C-Elegans/cpe_senior_project/desktop_app/README.md

# GTK Desktop App

## GTK Programming Tutorial
https://developer.gnome.org/gtkmm-tutorial/3.24/
