C-Elegans/cpe_senior_project/pcb/senior_project_pcb/senior_project_pcb.kicad_pcb

## KiCad design pcb/senior_project_pcb/senior_project_pcb.kicad_pcb (2021-02-25)

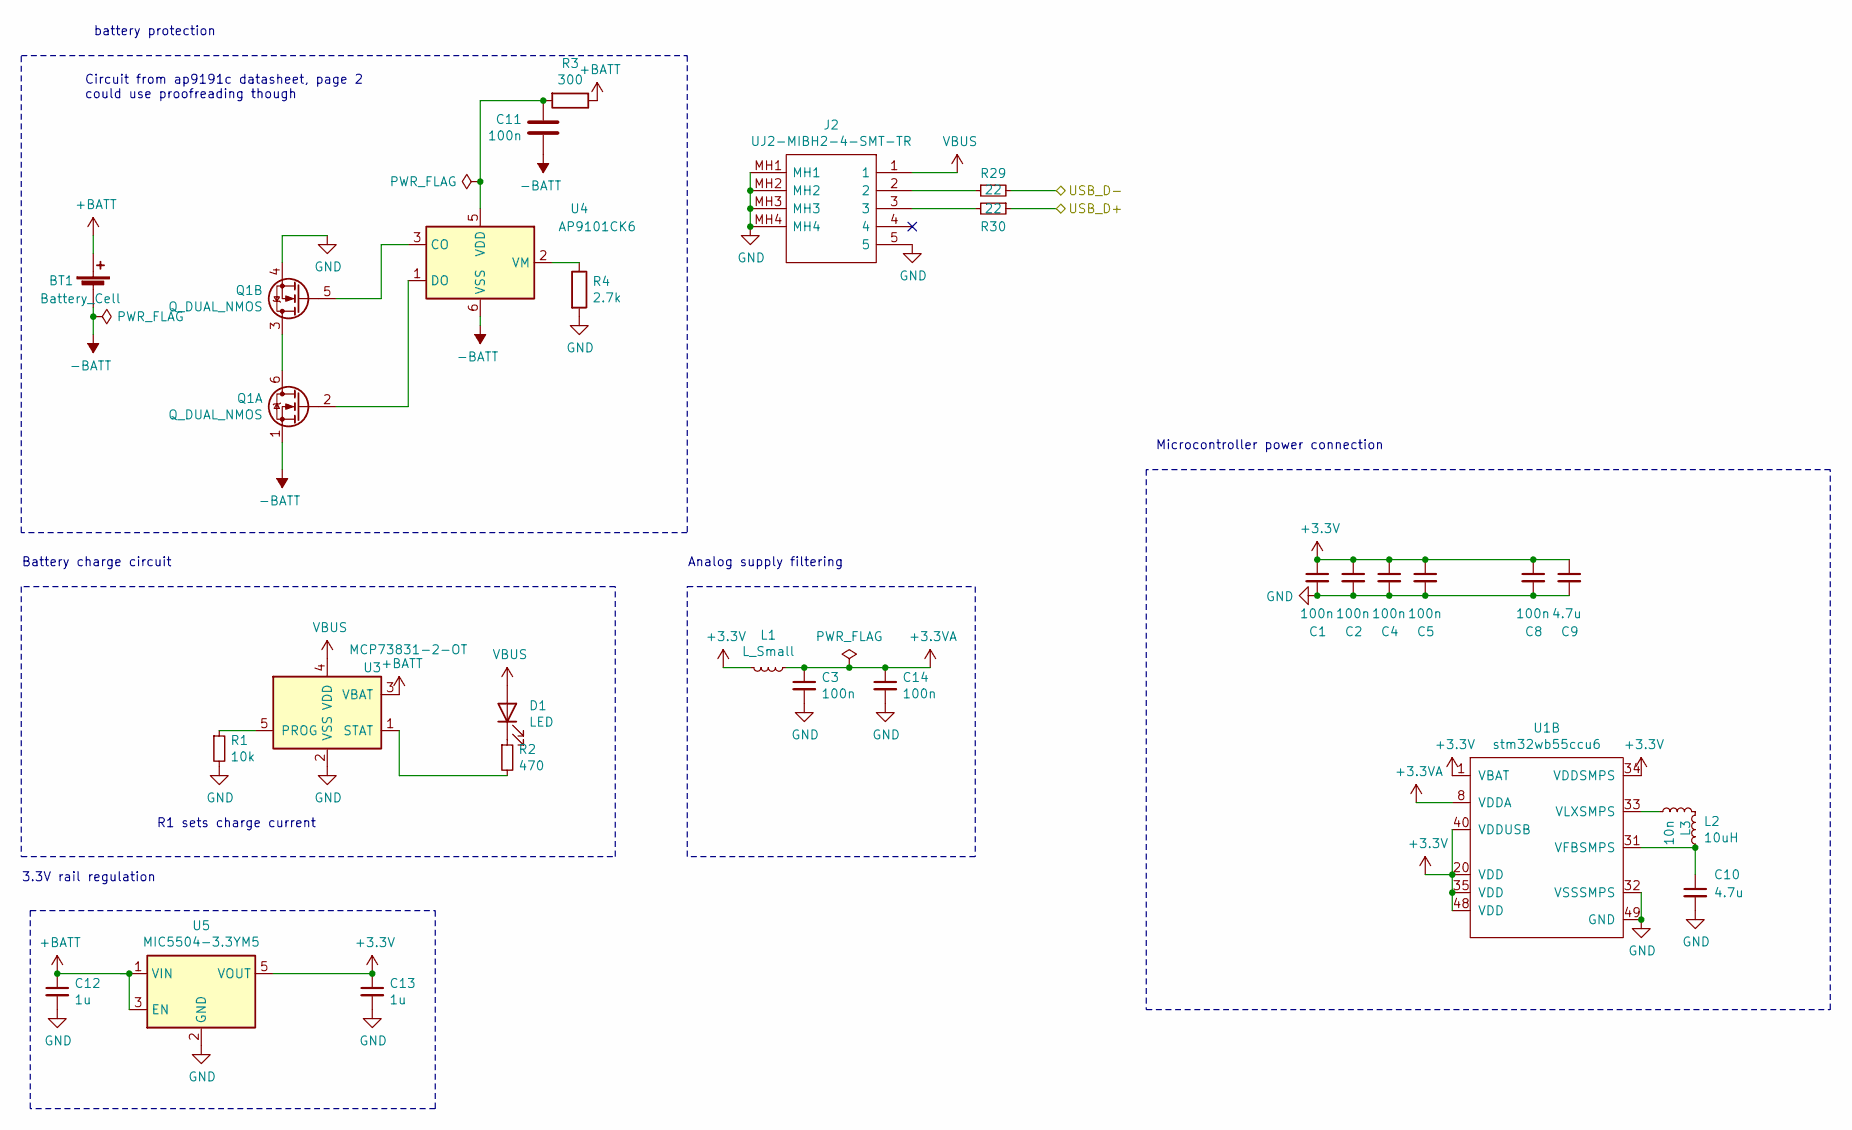
[picture p1: schematic power.sch]

Parts:
BT1: Battery_Cell; PinHeader_1x02_P2.54mm_Vertical
C1, C2, C3, C4, C5, C8, C11, C14: 100n; C_0603_1608Metric; Manufacturer_Part_Number 0603YC104MAT4A; Mouser Part Number 581-0603YC104MAT4A
C9, C10: 4.7u; C_0603_1608Metric; Manufacturer_Part_Number CL10A475KP8NNNC; Mouser Part Number 187-CL10A475KP8NNNC
C12, C13: 1u; C_0603_1608Metric; Manufacturer_Part_Number C0603C105K8PACTU; Mouser Part Number 80-C0603C105K8P
D1: LED; LED_0603_1608Metric; Manufacturer_Part_Number 150060RS75000; Mouser Part Number 710-150060RS75000
J2: UJ2-MIBH2-4-SMT-TR; UJ2MIBH24SMTTR; Manufacturer_Part_Number UJ2-MIBH2-4-SMT-TR; Mouser Part Number 490-UJ2-MIBH2-4-SMT
L1: L_Small; L_0805_2012Metric; Manufacturer_Part_Number LBR2012T100K; Mouser Part Number 963-LBR2012T100K
L2: 10uH; L_0805_2012Metric; Manufacturer_Part_Number LBR2012T100K; Mouser Part Number 963-LBR2012T100K
L3: 10n; L_0402_1005Metric; Manufacturer_Part_Number LQG15WH10NJ02D; Mouser Part Number 81-LQG15WH10NJ02D
Q1: Q_DUAL_NMOS; SOT-363_SC-70-6; Manufacturer_Part_Number BSS138BKS\\,115; Mouser Part Number 771-BSS138BKS115
R1: 10k; R_0603_1608Metric; Manufacturer_Part_Number RC0603FR-0710KL; Mouser Part Number 603-RC0603FR-0710KL
R2: 470; R_0603_1608Metric; Manufacturer_Part_Number RC0603FR-10470RL; Mouser Part Number 603-RC0603FR-10470RL
R3: 300; R_0603_1608Metric; Manufacturer_Part_Number RC0603FR-10300RL; Mouser Part Number 603-RC0603FR-10300RL
R4: 2.7k; R_0603_1608Metric; Manufacturer_Part_Number RC0603FR-072K7L; Mouser Part Number 603-RC0603FR-072K7L
R29, R30: 22; R_0603_1608Metric; Manufacturer_Part_Number RC0603FR-0722RL; Mouser Part Number 603-RC0603FR-0722RL
U1: stm32wb55ccu6; QFN-48-1EP_7x7mm_P0.5mm_EP5.6x5.6mm; Manufacturer_Part_Number STM32WB55CEU6; Mouser Part Number 511-STM32WB55CEU6
U3: MCP73831-2-OT; SOT-23-5; Manufacturer_Part_Number MCP73831T-2DCI/OT; Mouser Part Number 579-MCP73831T-2DCIOT
U4: AP9101CK6; SOT-23-6; Manufacturer_Part_Number AP9101CAK6-AYTRG1; Mouser Part Number 621-AP9101CAK6AYTRG1
U5: MIC5504-3.3YM5; SOT-23-5; Manufacturer_Part_Number MIC5504-3.3YM5-TR; Mouser Part Number 998-MIC5504-3.3YM5TR

Connections:
+3.3VA: C3.1, C14.1, L1.1, U1.8 (VDDA); also elsewhere on the board
+BATT: BT1.1 (+), C12.1, R3.1, U3.3 (VBAT), U5.1 (VIN), U5.3 (EN)
-BATT: BT1.2 (-), C11.1, Q1.1 (S), U4.6 (VSS)
/USB_D+: R29.1; also elsewhere on the board
/USB_D-: R30.2; also elsewhere on the board
GND: C1.2, C2.2, C3.2, C4.2, C5.2, C8.2, C9.2, C10.2, C12.2, C13.2, C14.2, J2.5, J2.MH1, J2.MH2, J2.MH3, J2.MH4, Q1.4 (S), R1.2, R4.2, U1.32 (VSSSMPS), U1.49 (GND), U3.2 (VSS), U5.2 (GND); also elsewhere on the board
unnamed: C10.1, L2.1, U1.31 (VFBSMPS)
unnamed: C11.2, R3.2, U4.5 (VDD)
unnamed: D1.1 (K), R2.1
unnamed: J2.2, R30.1
unnamed: J2.3, R29.2
unnamed: L2.2, L3.2
unnamed: L3.1, U1.33 (VLXSMPS)
unnamed: Q1.2 (G), U4.1 (DO)
unnamed: Q1.3 (D), Q1.6 (D)
unnamed: Q1.5 (G), U4.3 (CO)
unnamed: R1.1, U3.5 (PROG)
unnamed: R2.2, U3.1 (STAT)
unnamed: R4.1, U4.2 (VM)
VBUS: D1.2 (A), J2.1, U3.4 (VDD)

Notes on the sheet:
Circuit from ap9191c datasheet, page 2 could use proofreading though
battery protection
Microcontroller power connection
R1 sets charge current
Battery charge circuit
3.3V rail regulation
Analog supply filtering

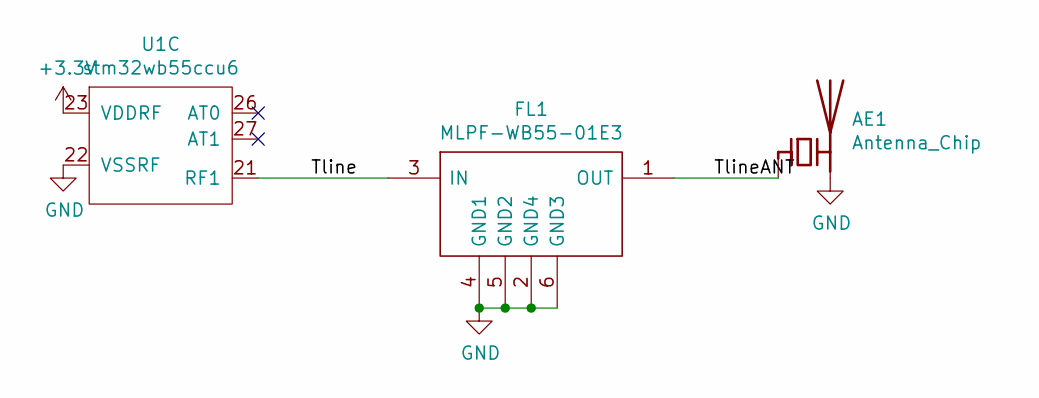
[picture p2: schematic rf.sch]

Parts:
AE1: Antenna_Chip; Texas_SWRA117D_2.4GHz_Left
FL1: MLPF-WB55-01E3; MLPFWB5501E3; Manufacturer_Part_Number MLPF-WB55-01E3; Mouser Part Number 511-MLPF-WB55-01E3
U1: stm32wb55ccu6; QFN-48-1EP_7x7mm_P0.5mm_EP5.6x5.6mm; Manufacturer_Part_Number STM32WB55CEU6; Mouser Part Number 511-STM32WB55CEU6

Connections:
/rf/Tline: FL1.3 (IN), U1.21 (RF1)
/rf/TlineANT: AE1.1 (FEED), FL1.1 (OUT)
GND: AE1.2 (PCB_Trace), FL1.2 (GND4), FL1.4 (GND1), FL1.5 (GND2), FL1.6 (GND3), U1.22 (VSSRF); also elsewhere on the board

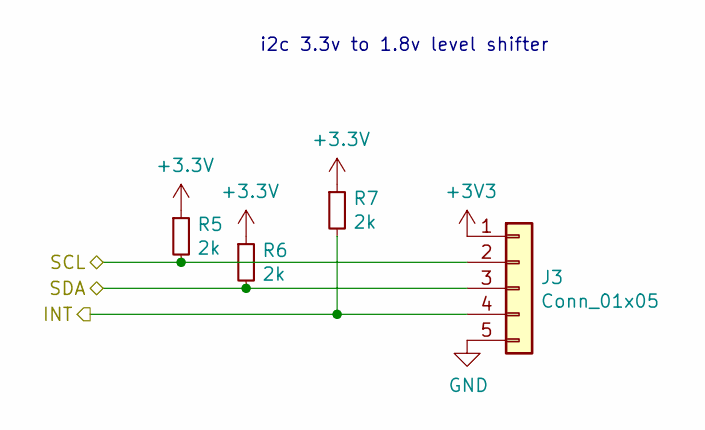
[picture p3: schematic pulse_oxy.sch]

Parts:
J3: Conn_01x05; PinHeader_1x05_P2.54mm_Vertical
R5, R6, R7: 2k; R_0603_1608Metric; Manufacturer_Part_Number RC0603FR-072KL; Mouser Part Number 603-RC0603FR-072KL

Connections:
/INT: J3.4, R7.2; also elsewhere on the board
/SCL: J3.2, R5.2; also elsewhere on the board
/SDA: J3.3, R6.2; also elsewhere on the board
GND: J3.5; also elsewhere on the board

Notes on the sheet:
i2c 3.3v to 1.8v level shifter

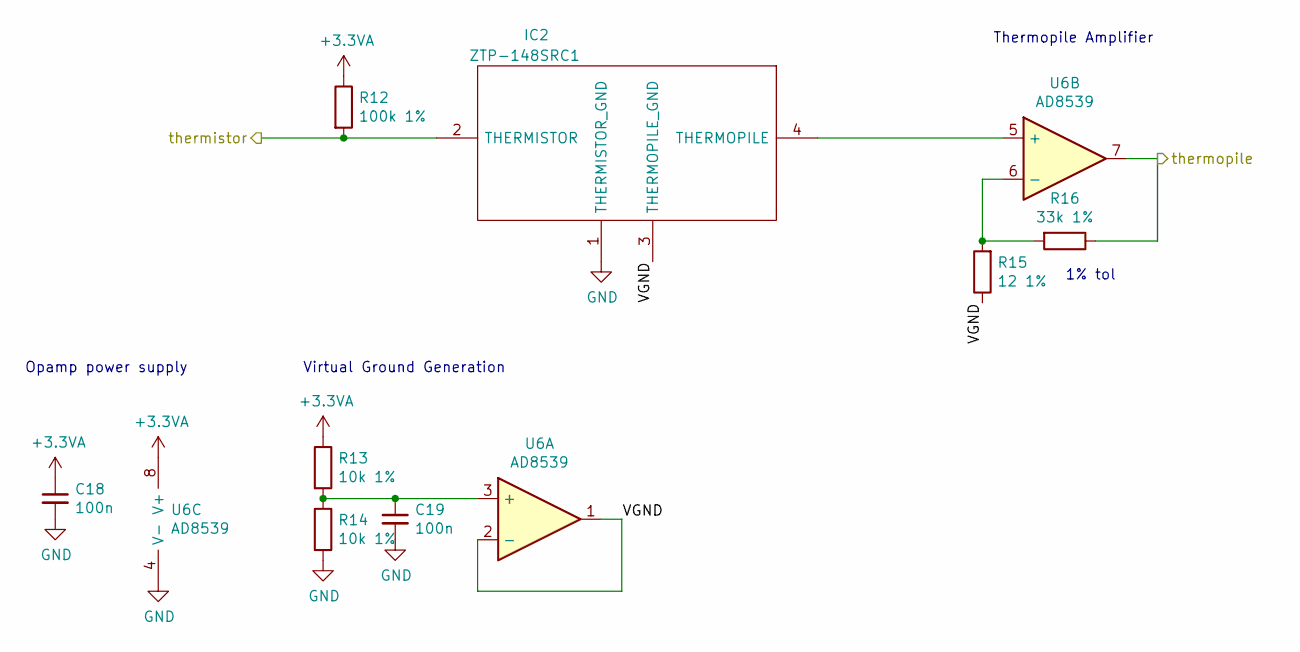
[picture p4: schematic temp_sensor.sch]

Parts:
C18, C19: 100n; C_0603_1608Metric; Manufacturer_Part_Number 0603YC104MAT4A; Mouser Part Number 581-0603YC104MAT4A
IC2: ZTP-148SRC1; ZTP148SRC1; Manufacturer_Part_Number ZTP-148SRC1; Mouser Part Number 527-ZTP-148SRC1
R12: 100k 1%; R_0603_1608Metric; Manufacturer_Part_Number RC0603FR-13100KL; Mouser Part Number 603-RC0603FR-13100KL
R13, R14: 10k 1%; R_0603_1608Metric; Manufacturer_Part_Number RC0603FR-0710KL; Mouser Part Number 603-RC0603FR-0710KL
R15: 12 1%; R_0603_1608Metric; Manufacturer_Part_Number RC0603FR-0712RL; Mouser Part Number 603-RC0603FR-0712RL
R16: 33k 1%; R_0603_1608Metric; Manufacturer_Part_Number RC0603FR-0733KL; Mouser Part Number 603-RC0603FR-0733KL
U6: AD8539; MSOP-8_3x3mm_P0.65mm; Manufacturer_Part_Number AD8539ARMZ; Mouser Part Number 584-AD8539ARMZ

Connections:
+3.3VA: C18.1, R12.1, R13.1, U6.8 (V+); also elsewhere on the board
/Temperature Sensor/VGND: IC2.3 (THERMOPILE_GND), R15.1, U6.1, U6.2 (-)
/thermistor: IC2.2 (THERMISTOR), R12.2; also elsewhere on the board
/thermopile: R16.1, U6.7; also elsewhere on the board
GND: C18.2, C19.2, IC2.1 (THERMISTOR_GND), R14.2, U6.4 (V-); also elsewhere on the board
unnamed: C19.1, R13.2, R14.1, U6.3 (+)
unnamed: IC2.4 (THERMOPILE), U6.5 (+)
unnamed: R15.2, R16.2, U6.6 (-)

Notes on the sheet:
Opamp power supply
Virtual Ground Generation
Thermopile Amplifier
1% tol

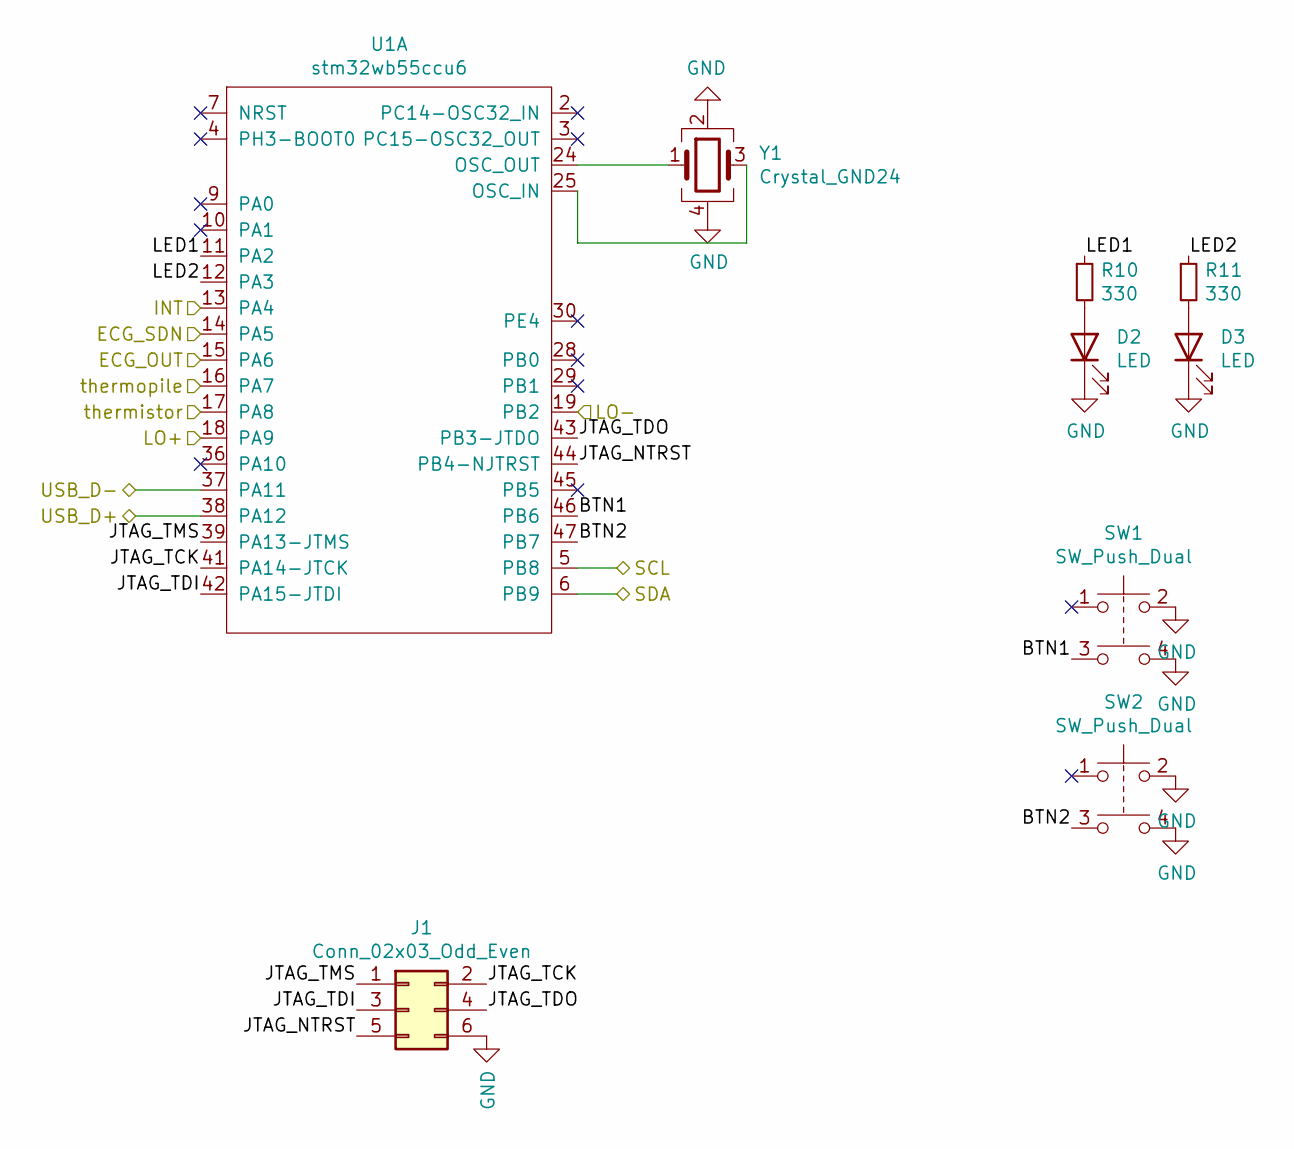
[picture p5: schematic io.sch]

Parts:
D2, D3: LED; LED_0603_1608Metric; Manufacturer_Part_Number 150060RS75000; Mouser Part Number 710-150060RS75000
J1: Conn_02x03_Odd_Even; PinHeader_2x03_P2.54mm_Vertical; Manufacturer_Part_Number 10-89-7061; Mouser Part Number 538-10-89-7061
R10, R11: 330; R_0603_1608Metric; Manufacturer_Part_Number RC0603JR-07330RL; Mouser Part Number 603-RC0603JR-07330RL
SW1, SW2: SW_Push_Dual; LL3301NF065QG; Manufacturer_Part_Number LL3301NF065QG; Mouser Part Number 612-LL3301NF065QG
U1: stm32wb55ccu6; QFN-48-1EP_7x7mm_P0.5mm_EP5.6x5.6mm; Manufacturer_Part_Number STM32WB55CEU6; Mouser Part Number 511-STM32WB55CEU6
Y1: Crystal_GND24; Crystal_SMD_2016-4Pin_2.0x1.6mm; Manufacturer_Part_Number XRCGB32M000F2P02R0; Mouser Part Number 81-XRCGB32M000F2P02R

Connections:
/ECG_OUT: U1.15 (PA6); also elsewhere on the board
/ECG_SDN: U1.14 (PA5); also elsewhere on the board
/INT: U1.13 (PA4); also elsewhere on the board
/LO+: U1.18 (PA9); also elsewhere on the board
/LO-: U1.19 (PB2); also elsewhere on the board
/SCL: U1.5 (PB8); also elsewhere on the board
/SDA: U1.6 (PB9); also elsewhere on the board
/USB_D+: U1.38 (PA12); also elsewhere on the board
/USB_D-: U1.37 (PA11); also elsewhere on the board
/io/BTN1: SW1.3, U1.46 (PB6)
/io/BTN2: SW2.3, U1.47 (PB7)
/io/JTAG_NTRST: J1.5, U1.44 (PB4-NJTRST)
/io/JTAG_TCK: J1.2, U1.41 (PA14-JTCK)
/io/JTAG_TDI: J1.3, U1.42 (PA15-JTDI)
/io/JTAG_TDO: J1.4, U1.43 (PB3-JTDO)
/io/JTAG_TMS: J1.1, U1.39 (PA13-JTMS)
/io/LED1: R10.1, U1.11 (PA2)
/io/LED2: R11.1, U1.12 (PA3)
/thermistor: U1.17 (PA8); also elsewhere on the board
/thermopile: U1.16 (PA7); also elsewhere on the board
GND: D2.1 (K), D3.1 (K), J1.6, SW1.2, SW1.4, SW2.2, SW2.4, Y1.2, Y1.4; also elsewhere on the board
unnamed: D2.2 (A), R10.2
unnamed: D3.2 (A), R11.2
unnamed: U1.24 (OSC_OUT), Y1.1
unnamed: U1.25 (OSC_IN), Y1.3

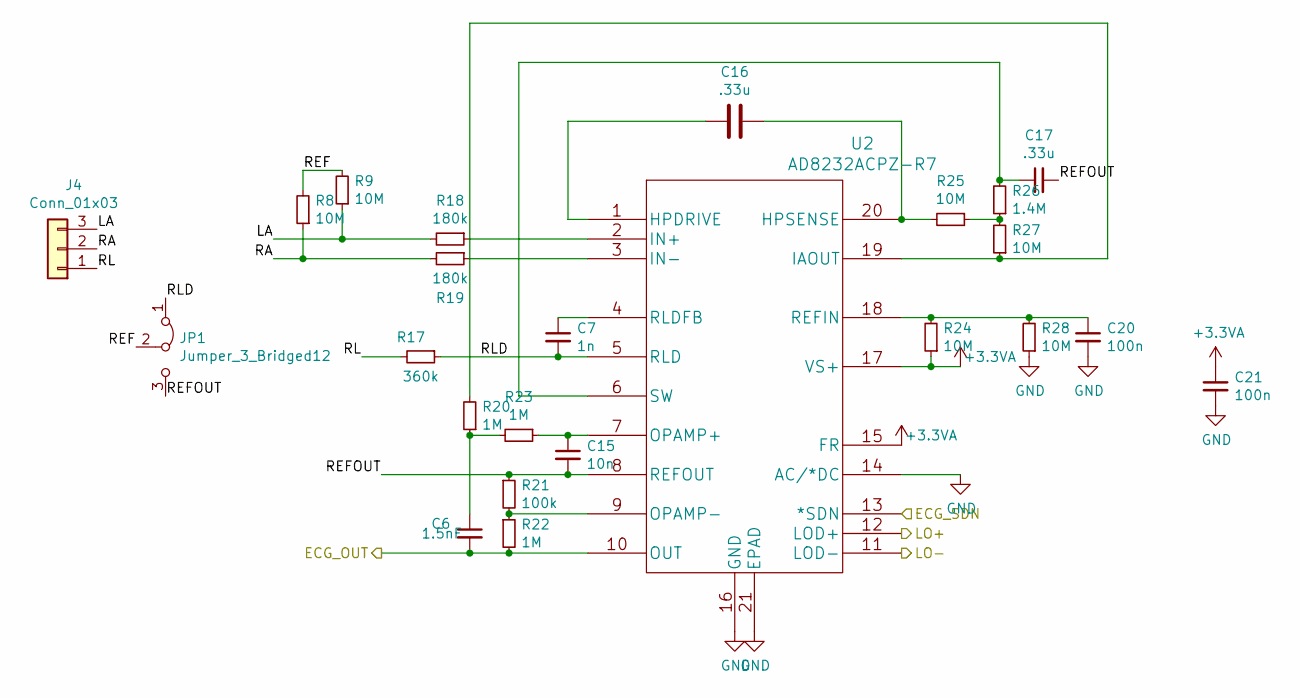
[picture p6: schematic ecg.sch]

Parts:
C6: 1.5nF; C_0603_1608Metric; Manufacturer_Part_Number 0603N152J250CT; Mouser Part Number 791-0603N152J250CT
C7: 1n; C_0603_1608Metric; Manufacturer_Part_Number 06035A102JAT2A; Mouser Part Number 581-06035A102J
C15: 10n; C_0603_1608Metric; Manufacturer_Part_Number 06035D103KAT2A; Mouser Part Number 581-06035D103KAT2A
C16, C17: .33u; C_0603_1608Metric; Manufacturer_Part_Number CL10B334KO8NNNC; Mouser Part Number 187-CL10B334KO8NNNC
C20, C21: 100n; C_0603_1608Metric; Manufacturer_Part_Number 0603YC104MAT4A; Mouser Part Number 581-0603YC104MAT4A
J4: Conn_01x03; PinHeader_1x03_P2.54mm_Vertical
JP1: Jumper_3_Bridged12; SolderJumper-3_P1.3mm_Bridged12_RoundedPad1.0x1.5mm
R8, R9, R24, R25, R27, R28: 10M; R_0603_1608Metric; Manufacturer_Part_Number RC0603FR-1010ML; Mouser Part Number 603-RC0603FR-1010ML
R17: 360k; R_0603_1608Metric; Manufacturer_Part_Number RC0603FR-07360KL; Mouser Part Number 603-RC0603FR-07360KL
R18, R19: 180k; R_0603_1608Metric; Manufacturer_Part_Number RC0603FR-10180KL; Mouser Part Number 603-RC0603FR-10180KL
R20, R22, R23: 1M; R_0603_1608Metric; Manufacturer_Part_Number RC0603FR-071ML; Mouser Part Number 603-RC0603FR-071ML
R21: 100k; R_0603_1608Metric; Manufacturer_Part_Number RC0603FR-13100KL; Mouser Part Number 603-RC0603FR-13100KL
R26: 1.4M; R_0603_1608Metric; Manufacturer_Part_Number RC0603FR-071M4L; Mouser Part Number 603-RC0603FR-071M4L
U2: AD8232ACPZ-R7; LFCSP-20-1EP_4x4mm_P0.5mm_EP2.1x2.1mm; Manufacturer_Part_Number AD8232ACPZ-R7; Mouser Part Number 584-AD8232ACPZ-R7

Connections:
+3.3VA: C21.1, R24.1, U2.15 (FR), U2.17 (VS+); also elsewhere on the board
/ECG_OUT: C6.2, R22.2, U2.10 (OUT); also elsewhere on the board
/ECG_SDN: U2.13 (*SDN); also elsewhere on the board
/LO+: U2.12 (LOD+); also elsewhere on the board
/LO-: U2.11 (LOD-); also elsewhere on the board
/ecg/LA: J4.3, R9.1, R18.2
/ecg/RA: J4.2, R8.1, R19.2
/ecg/REF: JP1.2 (C), R8.2, R9.2
/ecg/REFOUT: C15.2, C17.2, JP1.3 (B), R21.1, U2.8 (REFOUT)
/ecg/RL: J4.1, R17.2
/ecg/RLD: C7.2, JP1.1 (A), R17.1, U2.5 (RLD)
GND: C20.2, C21.2, R28.1, U2.14 (AC/*DC), U2.16 (GND), U2.21 (EPAD); also elsewhere on the board
unnamed: C6.1, R20.1, R23.2
unnamed: C7.1, U2.4 (RLDFB)
unnamed: C15.1, R23.1, U2.7 (OPAMP+)
unnamed: C16.1, R25.2, U2.20 (HPSENSE)
unnamed: C16.2, U2.1 (HPDRIVE)
unnamed: C17.1, R26.2, U2.6 (SW)
unnamed: C20.1, R24.2, R28.2, U2.18 (REFIN)
unnamed: R18.1, U2.2 (IN+)
unnamed: R19.1, U2.3 (IN-)
unnamed: R20.2, R27.1, U2.19 (IAOUT)
unnamed: R21.2, R22.1, U2.9 (OPAMP-)
unnamed: R25.1, R26.1, R27.2

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
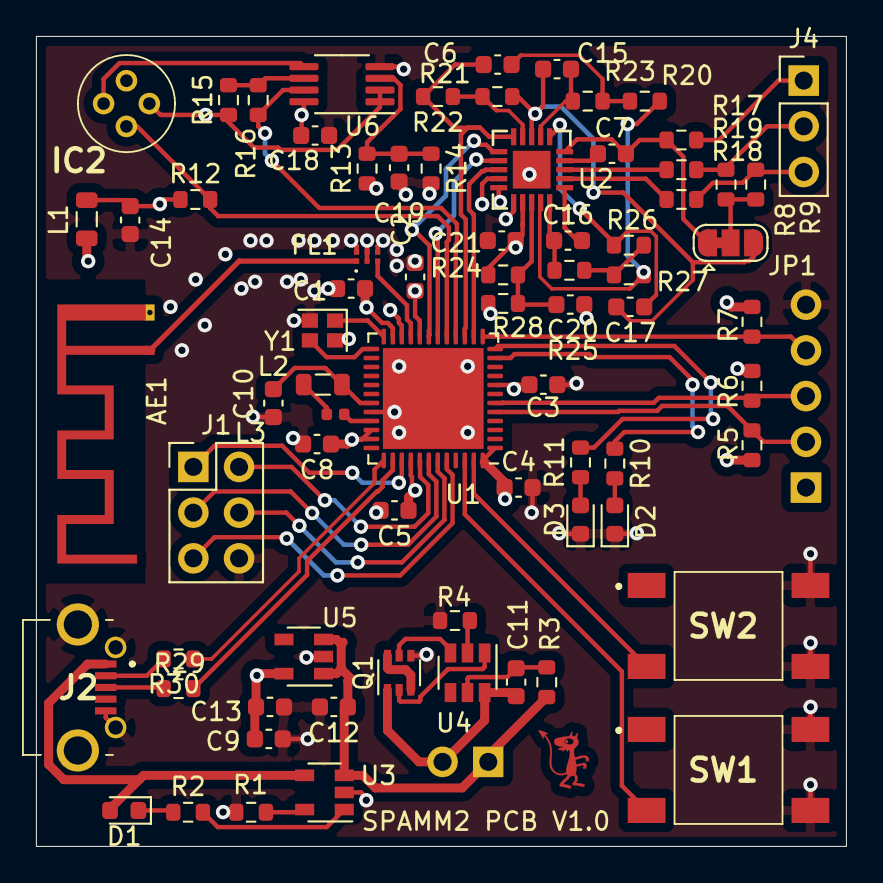
[picture p7: board senior_project_pcb.kicad_pcb from above]

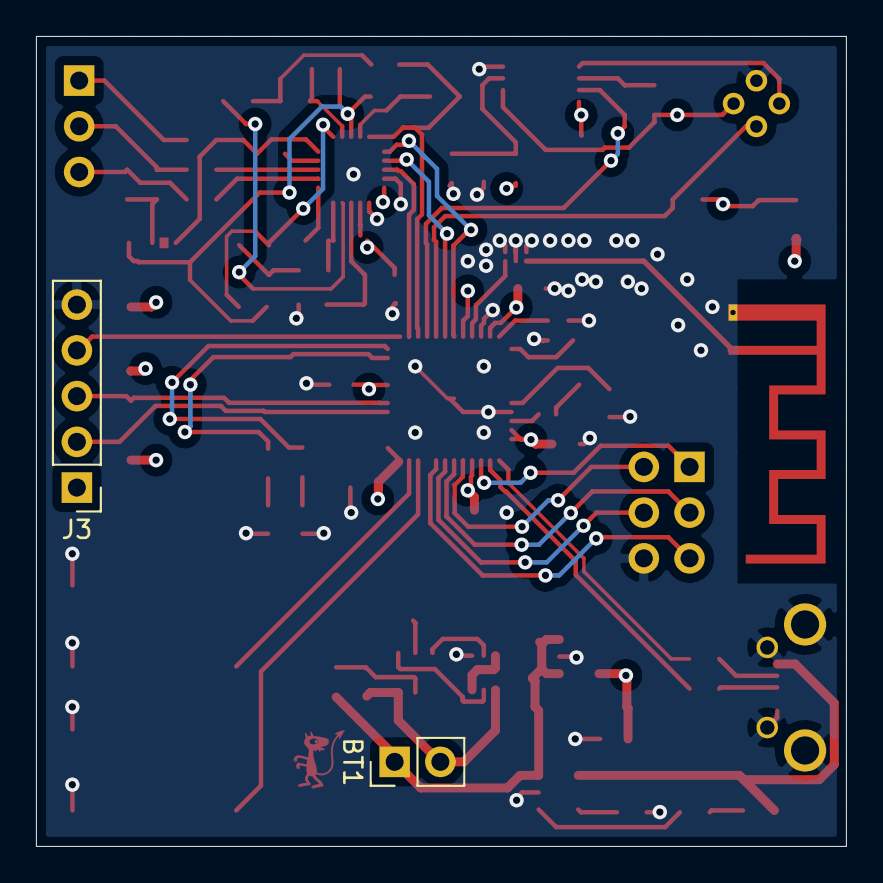
[picture p8: board senior_project_pcb.kicad_pcb from below]

Board: 4 copper layers, 45.0 x 45.0 mm, 76 parts (2 on the bottom side), 67 nets.
