C-Elegans/cpe_senior_project/wsp_src/Core/Src/main.c

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
/* Includes ------------------------------------------------------------------*/
#include "main.h"
#include "cmsis_os.h"
#include "usb_device.h"

/* USER CODE BEGIN Includes */
#include "usbd_cdc_if.h"
#include "stm_smps.h"
#include "adc.h"
#include "temperature.h"
#include "ecg.h"
#include "morse_tx.h"
#include "menu.h"
#include "das.h"
#include "MAX30102/MAX30102.h"
#include "string.h"
#include "stdio.h"
#include "usb_printf.h"

/* USER CODE END Includes */

typedef StaticTask_t osStaticThreadDef_t;
ADC_HandleTypeDef hadc1;

I2C_HandleTypeDef hi2c1;

TIM_HandleTypeDef htim2;

/* Definitions for defaultTask */
osThreadId_t defaultTaskHandle;
const osThreadAttr_t defaultTask_attributes = {
  .name = "defaultTask",
  .priority = (osPriority_t) osPriorityNormal,
  .stack_size = 128 * 4
};
/* Definitions for max30102Task */
osThreadId_t max30102TaskHandle;
uint32_t max30102TaskBuffer[ 256 ];
osStaticThreadDef_t max30102TaskControlBlock;
const osThreadAttr_t max30102Task_attributes = {
  .name = "max30102Task",
  .stack_mem = &max30102TaskBuffer[0],
  .stack_size = sizeof(max30102TaskBuffer),
  .cb_mem = &max30102TaskControlBlock,
  .cb_size = sizeof(max30102TaskControlBlock),
  .priority = (osPriority_t) osPriorityRealtime,
};
/* Definitions for usbTask */
osThreadId_t usbTaskHandle;
uint32_t usbTaskBuffer[ 512 ];
osStaticThreadDef_t usbTaskControlBlock;
const osThreadAttr_t usbTask_attributes = {
  .name = "usbTask",
  .stack_mem = &usbTaskBuffer[0],
  .stack_size = sizeof(usbTaskBuffer),
  .cb_mem = &usbTaskControlBlock,
  .cb_size = sizeof(usbTaskControlBlock),
  .priority = (osPriority_t) osPriorityLow,
};
/* Definitions for ecgTask */
osThreadId_t ecgTaskHandle;
const osThreadAttr_t ecgTask_attributes = {
  .name = "ecgTask",
  .priority = (osPriority_t) osPriorityHigh,
  .stack_size = 512 * 4
};
void SystemClock_Config(void);
static void MX_GPIO_Init(void);
static void MX_ADC1_Init(void);
static void MX_I2C1_Init(void);
static void MX_TIM2_Init(void);
void StartDefaultTask(void *argument);
void StartMax30102Task(void *argument);
void StartUSBTask(void *argument);
void StartECGTask(void *argument);

/**
  * @brief  The application entry point.
  * @retval int
  */
int main(void)
{
  /* MCU Configuration--------------------------------------------------------*/

  /* Reset of all peripherals, Initializes the Flash interface and the Systick. */
  HAL_Init();

  /* Configure the system clock */
  SystemClock_Config();

  /* Initialize all configured peripherals */
  MX_GPIO_Init();
  MX_USB_Device_Init();
  MX_ADC1_Init();
  MX_I2C1_Init();
  MX_TIM2_Init();
  /* USER CODE BEGIN 2 */
  Max30102_Init(&hi2c1);
  Max30102_ShutdownMode(1);
  //enable_smps();
  /* USER CODE END 2 */

  /* Init scheduler */
  osKernelInitialize();

  /* USER CODE BEGIN RTOS_MUTEX */
  /* add mutexes, ... */
  /* USER CODE END RTOS_MUTEX */

  /* USER CODE BEGIN RTOS_SEMAPHORES */
  /* add semaphores, ... */
  /* USER CODE END RTOS_SEMAPHORES */

  /* USER CODE BEGIN RTOS_TIMERS */
  /* start timers, add new ones, ... */
  /* USER CODE END RTOS_TIMERS */

  /* USER CODE BEGIN RTOS_QUEUES */
  /* add queues, ... */
  /* USER CODE END RTOS_QUEUES */

  /* Create the thread(s) */
  /* creation of defaultTask */
  defaultTaskHandle = osThreadNew(StartDefaultTask, NULL, &defaultTask_attributes);

  /* creation of max30102Task */
  max30102TaskHandle = osThreadNew(StartMax30102Task, NULL, &max30102Task_attributes);

  /* creation of usbTask */
  usbTaskHandle = osThreadNew(StartUSBTask, NULL, &usbTask_attributes);

  /* creation of ecgTask */
  ecgTaskHandle = osThreadNew(StartECGTask, NULL, &ecgTask_attributes);

  /* USER CODE BEGIN RTOS_THREADS */
  /* add threads, ... */
  /* USER CODE END RTOS_THREADS */

  /* Start scheduler */
  osKernelStart();

  /* We should never get here as control is now taken by the scheduler */
  /* Infinite loop */
  /* USER CODE BEGIN WHILE */
  while (1)
  {
    /* USER CODE END WHILE */

    /* USER CODE BEGIN 3 */


  }
  /* USER CODE END 3 */
}

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
/* USER CODE BEGIN 4 */

// Can be used to see which button is causing the main task to wake up
volatile uint8_t notify_button_value;

void HAL_GPIO_EXTI_Callback(uint16_t GPIO_Pin){
	if (notify_button_value == 0) {
		if (GPIO_Pin == BTN1_Pin) {
			notify_button_value |= 1;
			BaseType_t taskWoken = pdFALSE;
			vTaskNotifyGiveFromISR(defaultTaskHandle, &taskWoken);
		}
		if (GPIO_Pin == BTN2_Pin) {
			notify_button_value |= 2;
			BaseType_t taskWoken = pdFALSE;
			vTaskNotifyGiveFromISR(defaultTaskHandle, &taskWoken);
		}
	}
	if (GPIO_Pin == SPO2_INT_Pin) {
		Max30102_InterruptCallback();
	}
	// Use button 2 for ECG control.
	/* if(GPIO_Pin == BTN2_Pin){ */
	/* 	if(ecg_enabled && (uint8_t)1 ){ */
	/* 		//Wait for the buffer to be marked as finished to be safe */
	/* 		//while(!buffer_finished); */
	/* 		stop_ecg_acquisition(); */
	/* 		HAL_GPIO_WritePin(LED1_GPIO_Port, LED1_Pin, GPIO_PIN_RESET); */
	/* 	} */
	/* 	else{ */
	/* 		start_ecg_acqisition(); */
	/* 		HAL_GPIO_WritePin(LED1_GPIO_Port, LED1_Pin, GPIO_PIN_SET); */
	/* 	} */
	/* } */

}

void print_adc(uint32_t channel, const char *name){
	uint32_t val = read_adc_channel(channel);
	usb_printf("%s: %lu\r\n", name, val);
}

void HAL_ADC_ConvCpltCallback(ADC_HandleTypeDef *hadc){
	if(ecg_enabled) ecg_adc_callback(HAL_ADC_GetValue(hadc));
}


/* USER CODE END 4 */

/* USER CODE BEGIN Header_StartDefaultTask */
/**
  * @brief  Function implementing the defaultTask thread.
  * @param  argument: Not used
  * @retval None
  */
/* USER CODE END Header_StartDefaultTask */
void StartDefaultTask(void *argument)
{
  /* USER CODE BEGIN 5 */
	/* Infinite loop */
	for (;;) {
		run_main_menu();
	}
  /* USER CODE END 5 */
}

/* USER CODE BEGIN Header_StartMax30102Task */
/**
* @brief Function implementing the max30102Task thread.
* @param argument: Not used
* @retval None
*/
/* USER CODE END Header_StartMax30102Task */
void StartMax30102Task(void *argument)
{
  /* USER CODE BEGIN StartMax30102Task */
  /* Infinite loop */
  for(;;)
  {
	Max30102_Task();
    osDelay(100);
  }
  /* USER CODE END StartMax30102Task */
}

/* USER CODE BEGIN Header_StartUSBTask */
/**
* @brief Function implementing the usbTask thread.
* @param argument: Not used
* @retval None
*/
/* USER CODE END Header_StartUSBTask */
void StartUSBTask(void *argument)
{
  /* USER CODE BEGIN StartUSBTask */
  /* Infinite loop */
  for(;;)
  {
      das_loop_fun();
      osDelay(1);
  }
  /* USER CODE END StartUSBTask */
}

/* USER CODE BEGIN Header_StartECGTask */
/**
* @brief Function implementing the ecgTask thread.
* @param argument: Not used
* @retval None
*/
/* USER CODE END Header_StartECGTask */
void StartECGTask(void *argument)
{
  /* USER CODE BEGIN StartECGTask */
	/* Infinite loop */
	for (;;) {

		// Wait for notification from ISR
		int notifiedvalue = ulTaskNotifyTake(pdFALSE, -1);
		if (notifiedvalue > 0) {
			run_ecg_filter();
		}
		osDelay(1);
	}
  /* USER CODE END StartECGTask */
}

/**
  * @brief  Period elapsed callback in non blocking mode
  * @note   This function is called  when TIM1 interrupt took place, inside
  * HAL_TIM_IRQHandler(). It makes a direct call to HAL_IncTick() to increment
  * a global variable "uwTick" used as application time base.
  * @param  htim : TIM handle
  * @retval None
  */
void HAL_TIM_PeriodElapsedCallback(TIM_HandleTypeDef *htim)
{
  if (htim->Instance == TIM1) {
    HAL_IncTick();
  }
  /* USER CODE BEGIN Callback 1 */

  if(htim->Instance == TIM2){
	  if(ecg_enabled)  ecg_tim_callback();
  }

  /* USER CODE END Callback 1 */
}

/**
  * @brief  This function is executed in case of error occurrence.
  * @retval None
  */
void Error_Handler(void)
{
  /* USER CODE BEGIN Error_Handler_Debug */
  /* User can add his own implementation to report the HAL error return state */

  /* USER CODE END Error_Handler_Debug */
}

#ifdef  USE_FULL_ASSERT
/**
  * @brief  Reports the name of the source file and the source line number
  *         where the assert_param error has occurred.
  * @param  file: pointer to the source file name
  * @param  line: assert_param error line source number
  * @retval None
  */
void assert_failed(uint8_t *file, uint32_t line)
{
  /* USER CODE BEGIN 6 */
  /* User can add his own implementation to report the file name and line number,
     tex: printf("Wrong parameters value: file %s on line %d\r\n", file, line) */
  /* USER CODE END 6 */
}
#endif /* USE_FULL_ASSERT */

/************************ (C) COPYRIGHT STMicroelectronics *****END OF FILE****/
