C-Elegans/cpe_senior_project/wsp_src/Core/Inc/main.h

#define LED1_Pin GPIO_PIN_2
#define LED1_GPIO_Port GPIOA
#define LED2_Pin GPIO_PIN_3
#define LED2_GPIO_Port GPIOA
#define SPO2_INT_Pin GPIO_PIN_4
#define SPO2_INT_GPIO_Port GPIOA
#define SPO2_INT_EXTI_IRQn EXTI4_IRQn
#define ECG_SDN_Pin GPIO_PIN_5
#define ECG_SDN_GPIO_Port GPIOA
#define ECG_OUT_Pin GPIO_PIN_6
#define ECG_OUT_GPIO_Port GPIOA
#define THERMOPILE_Pin GPIO_PIN_7
#define THERMOPILE_GPIO_Port GPIOA
#define THERMISTOR_Pin GPIO_PIN_8
#define THERMISTOR_GPIO_Port GPIOA
#define LO_P_Pin GPIO_PIN_9
#define LO_P_GPIO_Port GPIOA
#define LO_N_Pin GPIO_PIN_2
#define LO_N_GPIO_Port GPIOB
#define BTN1_Pin GPIO_PIN_6
#define BTN1_GPIO_Port GPIOB
#define BTN1_EXTI_IRQn EXTI9_5_IRQn
#define BTN2_Pin GPIO_PIN_7
#define BTN2_GPIO_Port GPIOB
#define BTN2_EXTI_IRQn EXTI9_5_IRQn
