C-Elegans/cpe_senior_project/mcu_src/Core/Src/main.c

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
/* Includes ------------------------------------------------------------------*/
#include "main.h"
#include "cmsis_os.h"
#include "usb_device.h"

/* USER CODE BEGIN Includes */
#include "usbd_cdc_if.h"
/* USER CODE END Includes */

ADC_HandleTypeDef hadc1;

/* Definitions for defaultTask */
osThreadId_t defaultTaskHandle;
const osThreadAttr_t defaultTask_attributes = {
  .name = "defaultTask",
  .priority = (osPriority_t) osPriorityNormal,
  .stack_size = 128 * 4
};
/* Definitions for blink */
osThreadId_t blinkHandle;
const osThreadAttr_t blink_attributes = {
  .name = "blink",
  .priority = (osPriority_t) osPriorityLow,
  .stack_size = 128 * 4
};
void SystemClock_Config(void);
static void MX_GPIO_Init(void);
static void MX_ADC1_Init(void);
void StartDefaultTask(void *argument);
void StartBlink(void *argument);

static void MX_NVIC_Init(void);
/**
  * @brief  The application entry point.
  * @retval int
  */
int main(void)
{
  /* MCU Configuration--------------------------------------------------------*/

  /* Reset of all peripherals, Initializes the Flash interface and the Systick. */
  HAL_Init();

  /* Configure the system clock */
  SystemClock_Config();

  /* Initialize all configured peripherals */
  MX_GPIO_Init();
  MX_ADC1_Init();

  /* Initialize interrupts */
  MX_NVIC_Init();
  /* Init scheduler */
  osKernelInitialize();

  /* USER CODE BEGIN RTOS_MUTEX */
  /* add mutexes, ... */
  /* USER CODE END RTOS_MUTEX */

  /* USER CODE BEGIN RTOS_SEMAPHORES */
  /* add semaphores, ... */
  /* USER CODE END RTOS_SEMAPHORES */

  /* USER CODE BEGIN RTOS_TIMERS */
  /* start timers, add new ones, ... */
  /* USER CODE END RTOS_TIMERS */

  /* USER CODE BEGIN RTOS_QUEUES */
  /* add queues, ... */
  /* USER CODE END RTOS_QUEUES */

  /* Create the thread(s) */
  /* creation of defaultTask */
  defaultTaskHandle = osThreadNew(StartDefaultTask, NULL, &defaultTask_attributes);

  /* creation of blink */
  blinkHandle = osThreadNew(StartBlink, NULL, &blink_attributes);

  /* USER CODE BEGIN RTOS_THREADS */
  /* add threads, ... */
  /* USER CODE END RTOS_THREADS */

  /* Start scheduler */
  osKernelStart();

  /* We should never get here as control is now taken by the scheduler */
  /* Infinite loop */
  /* USER CODE BEGIN WHILE */
  while (1)
  {
    /* USER CODE END WHILE */

    /* USER CODE BEGIN 3 */
  }
  /* USER CODE END 3 */
}

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
/* USER CODE BEGIN 4 */
void HAL_GPIO_EXTI_Callback(uint16_t GPIO_Pin) {
	if(GPIO_Pin == GPIO_PIN_0){
		// Wake up the StartBlink Task
		BaseType_t taskWoken = pdFALSE;
		vTaskNotifyGiveFromISR(blinkHandle, &taskWoken);
	}
}

/* USER CODE END 4 */

/* USER CODE BEGIN 4 */

volatile uint8_t adcflag = 0;
volatile uint32_t adcval = 0;

// So this function gets called by HAL_ADC_IRQHandler upon an ADC IRQ with the EOC and EOS flags set (I think)
// This function needs to set a flag in order for the main program to know that the data from the adc
// has been retreived (or something else, just PollForConversion will no longer work)
void HAL_ADC_ConvCpltCallback(ADC_HandleTypeDef *hadc){
	adcval = HAL_ADC_GetValue(&hadc1);
	adcflag = 1;
}
/* USER CODE END 4 */

/* USER CODE BEGIN Header_StartDefaultTask */
/**
  * @brief  Function implementing the defaultTask thread.
  * @param  argument: Not used
  * @retval None
  */
/* USER CODE END Header_StartDefaultTask */
void StartDefaultTask(void *argument)
{
  /* init code for USB_DEVICE */
  MX_USB_DEVICE_Init();
  /* USER CODE BEGIN 5 */
  /* Infinite loop */
  for(;;)
  {
	  // To read from the ADC, you apparently need to start a conversion,
	  // wait for the conversion to complete, then read the ADC value
	  HAL_ADC_Start_IT(&hadc1);

	  // Wait until an ADC_ConvCpltCallback
	  while(!adcflag) {}
	  // ADC data available in adcval
	  adcflag = 0;

	  // Send a message over the USB port
	  unsigned char buffer[50];
	  snprintf((char*)buffer, sizeof(buffer)-1, "adc val: %ld\r\n", adcval);
	  CDC_Transmit_FS(buffer, strlen(buffer));
	  osDelay(1000);
  }
  /* USER CODE END 5 */
}

/* USER CODE BEGIN Header_StartBlink */
/* Example of how to wait for a pin to change state. GPIO Pin PA0 is
   configured as an EXTI Interrupt which triggers the
   HAL_GIO_EXTI_Callback function above. Interrupt handling can be
   done in that function, however for lengthy tasks (such as setting a
   gpio pin, waiting for 1s, then clearing it)

   In this case, I have the EXTI interrupt callback set up to notify
   the StartBlink function when it is called, waking up the StartBlink
   function and allowing it to do its thing
 */

/* USER CODE END Header_StartBlink */
void StartBlink(void *argument)
{
  /* USER CODE BEGIN StartBlink */
  /* Infinite loop */
  for(;;)
  {
	  // Wait for wakeup event
	  int notifiedvalue = ulTaskNotifyTake(pdFALSE, -1);
	  if(notifiedvalue > 0){
		  // do whatever. In this case, light the led for 1 second
		  HAL_GPIO_WritePin(GPIOE, LD_G_Pin, GPIO_PIN_SET);
		  osDelay(1000);
		  HAL_GPIO_WritePin(GPIOE, LD_G_Pin, GPIO_PIN_RESET);
	  }
      osDelay(500);
  }
  /* USER CODE END StartBlink */
}

/**
  * @brief  Period elapsed callback in non blocking mode
  * @note   This function is called  when TIM6 interrupt took place, inside
  * HAL_TIM_IRQHandler(). It makes a direct call to HAL_IncTick() to increment
  * a global variable "uwTick" used as application time base.
  * @param  htim : TIM handle
  * @retval None
  */
void HAL_TIM_PeriodElapsedCallback(TIM_HandleTypeDef *htim)
{
  if (htim->Instance == TIM6) {
    HAL_IncTick();
  }
}

/**
  * @brief  This function is executed in case of error occurrence.
  * @retval None
  */
void Error_Handler(void)
{
  /* USER CODE BEGIN Error_Handler_Debug */
  /* User can add his own implementation to report the HAL error return state */

  /* USER CODE END Error_Handler_Debug */
}

#ifdef  USE_FULL_ASSERT
/**
  * @brief  Reports the name of the source file and the source line number
  *         where the assert_param error has occurred.
  * @param  file: pointer to the source file name
  * @param  line: assert_param error line source number
  * @retval None
  */
void assert_failed(uint8_t *file, uint32_t line)
{
  /* USER CODE BEGIN 6 */
  /* User can add his own implementation to report the file name and line number,
     tex: printf("Wrong parameters value: file %s on line %d\r\n", file, line) */
  /* USER CODE END 6 */
}
#endif /* USE_FULL_ASSERT */

/************************ (C) COPYRIGHT STMicroelectronics *****END OF FILE****/
