C-Elegans/cpe_senior_project/wsp_src/Core/Src/MAX30102/MAX30102.c

/** \file max30102.cpp ******************************************************
*
* Project: MAXREFDES117#
* Filename: max30102.cpp
* Description: This module is an embedded controller driver for the MAX30102
*
*
* --------------------------------------------------------------------
*
* This code follows the following naming conventions:
*
* char              ch_pmod_value
* char (array)      s_pmod_s_string[16]
* float             f_pmod_value
* int32_t           n_pmod_value
* int32_t (array)   an_pmod_value[16]
* int16_t           w_pmod_value
* int16_t (array)   aw_pmod_value[16]
* uint16_t          uw_pmod_value
* uint16_t (array)  auw_pmod_value[16]
* uint8_t           uch_pmod_value
* uint8_t (array)   auch_pmod_buffer[16]
* uint32_t          un_pmod_value
* int32_t *         pn_pmod_value
*
* ------------------------------------------------------------------------- */
/*******************************************************************************
* Copyright (C) 2016 Maxim Integrated Products, Inc., All Rights Reserved.
*
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
* Except as contained in this notice, the name of Maxim Integrated
* Products, Inc. shall not be used except as stated in the Maxim Integrated
* Products, Inc. Branding Policy.
*
* The mere transfer of this software does not imply any licenses
* of trade secrets, proprietary technology, copyrights, patents,
* trademarks, maskwork rights, or any other form of intellectual
* property whatsoever. Maxim Integrated Products, Inc. retains all
* ownership rights.
*******************************************************************************
*  Modified original MAXIM source code on: 13.01.2019
*		Author: Mateusz Salamon
*		www.msalamon.pl
*		mateusz@msalamon.pl
*	Code is modified to work with STM32 HAL libraries.
*
*	Website: https://msalamon.pl/palec-mi-pulsuje-pulsometr-max30102-pod-kontrola-stm32/
*	GitHub:  https://github.com/lamik/MAX30102_STM32_HAL
*
*/
#include "main.h"


#include "MAX30102/MAX30102.h"
#include "MAX30102/algorithm.h"

#define I2C_TIMEOUT	1

I2C_HandleTypeDef *i2c_max30102;

volatile uint32_t IrBuffer[MAX30102_BUFFER_LENGTH]; //IR LED sensor data
volatile uint32_t RedBuffer[MAX30102_BUFFER_LENGTH];    //Red LED sensor data
volatile uint32_t BufferHead;
volatile uint32_t BufferTail;
volatile uint32_t CollectedSamples;
volatile uint8_t IsFingerOnScreen;
int32_t Sp02Value;
int8_t Sp02IsValid;
int32_t HeartRate;
int8_t IsHrValid;

typedef enum
{
	MAX30102_STATE_BEGIN,
	MAX30102_STATE_CALIBRATE,
	MAX30102_STATE_CALCULATE_HR,
	MAX30102_STATE_COLLECT_NEXT_PORTION
}MAX30102_STATE;

MAX30102_STATE StateMachine;

MAX30102_STATUS Max30102_WriteReg(uint8_t uch_addr, uint8_t uch_data)
{
	if(HAL_I2C_Mem_Write(i2c_max30102, MAX30102_ADDRESS, uch_addr, 1, &uch_data, 1, I2C_TIMEOUT) == HAL_OK)
		return MAX30102_OK;
	return MAX30102_ERROR;
}

MAX30102_STATUS Max30102_ReadReg(uint8_t uch_addr, uint8_t *puch_data)
{
	if(HAL_I2C_Mem_Read(i2c_max30102, MAX30102_ADDRESS, uch_addr, 1, puch_data, 1, I2C_TIMEOUT) == HAL_OK)
		return MAX30102_OK;
	return MAX30102_ERROR;
}

MAX30102_STATUS Max30102_WriteRegisterBit(uint8_t Register, uint8_t Bit, uint8_t Value)
{
	uint8_t tmp;
	if(MAX30102_OK != Max30102_ReadReg(Register, &tmp))
		return MAX30102_ERROR;
	tmp &= ~(1<<Bit);
	tmp |= (Value&0x01)<<Bit;
	if(MAX30102_OK != Max30102_WriteReg(Register, tmp))
		return MAX30102_ERROR;

	return MAX30102_OK;
}

MAX30102_STATUS Max30102_ReadFifo(volatile uint32_t *pun_red_led, volatile uint32_t *pun_ir_led)
{
	uint32_t un_temp;
	*pun_red_led=0;
	*pun_ir_led=0;
	uint8_t ach_i2c_data[6];

	if(HAL_I2C_Mem_Read(i2c_max30102, MAX30102_ADDRESS, REG_FIFO_DATA, 1, ach_i2c_data, 6, I2C_TIMEOUT) != HAL_OK)
	{
		return MAX30102_ERROR;
	}
	un_temp=(unsigned char) ach_i2c_data[0];
	un_temp<<=16;
	*pun_red_led+=un_temp;
	un_temp=(unsigned char) ach_i2c_data[1];
	un_temp<<=8;
	*pun_red_led+=un_temp;
	un_temp=(unsigned char) ach_i2c_data[2];
	*pun_red_led+=un_temp;

	un_temp=(unsigned char) ach_i2c_data[3];
	un_temp<<=16;
	*pun_ir_led+=un_temp;
	un_temp=(unsigned char) ach_i2c_data[4];
	un_temp<<=8;
	*pun_ir_led+=un_temp;
	un_temp=(unsigned char) ach_i2c_data[5];
	*pun_ir_led+=un_temp;
	*pun_red_led&=0x03FFFF;  //Mask MSB [23:18]
	*pun_ir_led&=0x03FFFF;  //Mask MSB [23:18]

	return MAX30102_OK;
}

//
//	Interrupts
//
MAX30102_STATUS Max30102_SetIntAlmostFullEnabled(uint8_t Enable)
{
	return Max30102_WriteRegisterBit(REG_INTR_ENABLE_1, INT_A_FULL_BIT, Enable);
}

MAX30102_STATUS Max30102_SetIntFifoDataReadyEnabled(uint8_t Enable)
{

	return Max30102_WriteRegisterBit(REG_INTR_ENABLE_1, INT_PPG_RDY_BIT, Enable);
}

MAX30102_STATUS Max30102_SetIntAmbientLightCancelationOvfEnabled(uint8_t Enable)
{

	return Max30102_WriteRegisterBit(REG_INTR_ENABLE_2, INT_ALC_OVF_BIT, Enable);
}
#ifdef MAX30102_USE_INTERNAL_TEMPERATURE
MAX30102_STATUS Max30102_SetIntInternalTemperatureReadyEnabled(uint8_t Enable)
{

	return Max30102_WriteRegisterBit(REG_INTR_ENABLE_2, INT_DIE_TEMP_RDY_BIT, Enable);
}
#endif
MAX30102_STATUS Max30102_ReadInterruptStatus(uint8_t *Status)
{
	uint8_t tmp;
	*Status = 0;

	if(MAX30102_OK != Max30102_ReadReg(REG_INTR_STATUS_1, &tmp))
		return MAX30102_ERROR;
	*Status |= tmp & 0xE1; // 3 highest bits
#ifdef MAX30102_USE_INTERNAL_TEMPERATURE
	if(MAX30102_OK != Max30102_ReadReg(REG_INTR_STATUS_2, &tmp))
		return MAX30102_ERROR;
	*Status |= tmp & 0x02;
#endif
	return MAX30102_OK;
}

void Max30102_InterruptCallback(void)
{
	uint8_t Status;
	while(MAX30102_OK != Max30102_ReadInterruptStatus(&Status));

	// Almost Full FIFO Interrupt handle
	if(Status & (1<<INT_A_FULL_BIT))
	{
		for(uint8_t i = 0; i < MAX30102_FIFO_ALMOST_FULL_SAMPLES; i++)
		{
			while(MAX30102_OK != Max30102_ReadFifo((RedBuffer+BufferHead), (IrBuffer+BufferHead)));
			if(IsFingerOnScreen)
			{
				if(IrBuffer[BufferHead] < MAX30102_IR_VALUE_FINGER_OUT_SENSOR) IsFingerOnScreen = 0;
			}
			else
			{
				if(IrBuffer[BufferHead] > MAX30102_IR_VALUE_FINGER_ON_SENSOR) IsFingerOnScreen = 1;
			}
			BufferHead = (BufferHead + 1) % MAX30102_BUFFER_LENGTH;
			CollectedSamples++;
		}
	}

	// New FIFO Data Ready Interrupt handle
	if(Status & (1<<INT_PPG_RDY_BIT))
	{
		while(MAX30102_OK != Max30102_ReadFifo((RedBuffer+BufferHead), (IrBuffer+BufferHead)));
		if(IsFingerOnScreen)
		{
			if(IrBuffer[BufferHead] < MAX30102_IR_VALUE_FINGER_OUT_SENSOR) IsFingerOnScreen = 0;
		}
		else
		{
			if(IrBuffer[BufferHead] > MAX30102_IR_VALUE_FINGER_ON_SENSOR) IsFingerOnScreen = 1;
		}
		BufferHead = (BufferHead + 1) % MAX30102_BUFFER_LENGTH;
		CollectedSamples++;
	}

	//  Ambient Light Cancellation Overflow Interrupt handle
	if(Status & (1<<INT_ALC_OVF_BIT))
	{

	}

	// Power Ready Interrupt handle
	if(Status & (1<<INT_PWR_RDY_BIT))
	{
	}
#ifdef MAX30102_USE_INTERNAL_TEMPERATURE
	// Internal Temperature Ready Interrupt handle
	if(Status & (1<<INT_DIE_TEMP_RDY_BIT))
	{

	}
#endif
}

//
//	FIFO Configuration
//
MAX30102_STATUS Max30102_FifoWritePointer(uint8_t Address)
{
	if(MAX30102_OK != Max30102_WriteReg(REG_FIFO_WR_PTR,(Address & 0x1F)))  //FIFO_WR_PTR[4:0]
			return MAX30102_ERROR;
	return MAX30102_OK;
}

MAX30102_STATUS Max30102_FifoOverflowCounter(uint8_t Address)
{
	if(MAX30102_OK != Max30102_WriteReg(REG_OVF_COUNTER,(Address & 0x1F)))  //OVF_COUNTER[4:0]
			return MAX30102_ERROR;
	return MAX30102_OK;
}

MAX30102_STATUS Max30102_FifoReadPointer(uint8_t Address)
{
	if(MAX30102_OK != Max30102_WriteReg(REG_FIFO_RD_PTR,(Address & 0x1F)))  //FIFO_RD_PTR[4:0]
			return MAX30102_ERROR;
	return MAX30102_OK;
}

MAX30102_STATUS Max30102_FifoSampleAveraging(uint8_t Value)
{
	uint8_t tmp;
	if(MAX30102_OK != Max30102_ReadReg(REG_FIFO_CONFIG, &tmp))
		return MAX30102_ERROR;
	tmp &= ~(0x07);
	tmp |= (Value&0x07)<<5;
	if(MAX30102_OK != Max30102_WriteReg(REG_FIFO_CONFIG, tmp))
		return MAX30102_ERROR;

	return MAX30102_OK;
}

MAX30102_STATUS Max30102_FifoRolloverEnable(uint8_t Enable)
{
	return Max30102_WriteRegisterBit(REG_FIFO_CONFIG, FIFO_CONF_FIFO_ROLLOVER_EN_BIT, (Enable & 0x01));
}

MAX30102_STATUS Max30102_FifoAlmostFullValue(uint8_t Value)
{
	if(Value < 17) Value = 17;
	if(Value > 32) Value = 32;
	Value = 32 - Value;
	uint8_t tmp;
	if(MAX30102_OK != Max30102_ReadReg(REG_FIFO_CONFIG, &tmp))
		return MAX30102_ERROR;
	tmp &= ~(0x0F);
	tmp |= (Value & 0x0F);
	if(MAX30102_OK != Max30102_WriteReg(REG_FIFO_CONFIG, tmp))
		return MAX30102_ERROR;

	return MAX30102_OK;
}
//
//	Mode Configuration
//
MAX30102_STATUS Max30102_ShutdownMode(uint8_t Enable)
{
	return Max30102_WriteRegisterBit(REG_MODE_CONFIG, MODE_SHDN_BIT, (Enable & 0x01));
}

MAX30102_STATUS Max30102_Reset(void)
{
	uint8_t tmp = 0xFF;
    if(MAX30102_OK != Max30102_WriteReg(REG_MODE_CONFIG,0x40))
        return MAX30102_ERROR;
    do
    {
    	if(MAX30102_OK != Max30102_ReadReg(REG_MODE_CONFIG, &tmp))
    		return MAX30102_ERROR;
    } while(tmp & (1<<6));

    return MAX30102_OK;
}

MAX30102_STATUS Max30102_SetMode(uint8_t Mode)
{
	uint8_t tmp;
	if(MAX30102_OK != Max30102_ReadReg(REG_MODE_CONFIG, &tmp))
		return MAX30102_ERROR;
	tmp &= ~(0x07);
	tmp |= (Mode & 0x07);
	if(MAX30102_OK != Max30102_WriteReg(REG_MODE_CONFIG, tmp))
		return MAX30102_ERROR;

	return MAX30102_OK;
}
//
//	SpO2 Configuration
//
MAX30102_STATUS Max30102_SpO2AdcRange(uint8_t Value)
{
	uint8_t tmp;
	if(MAX30102_OK != Max30102_ReadReg(REG_SPO2_CONFIG, &tmp))
		return MAX30102_ERROR;
	tmp &= ~(0x03);
	tmp |= ((Value & 0x03) << 5);
	if(MAX30102_OK != Max30102_WriteReg(REG_SPO2_CONFIG, tmp))
		return MAX30102_ERROR;

	return MAX30102_OK;
}

MAX30102_STATUS Max30102_SpO2SampleRate(uint8_t Value)
{
	uint8_t tmp;
	if(MAX30102_OK != Max30102_ReadReg(REG_SPO2_CONFIG, &tmp))
		return MAX30102_ERROR;
	tmp &= ~(0x07);
	tmp |= ((Value & 0x07) << 2);
	if(MAX30102_OK != Max30102_WriteReg(REG_SPO2_CONFIG, tmp))
		return MAX30102_ERROR;

	return MAX30102_OK;
}

MAX30102_STATUS Max30102_SpO2LedPulseWidth(uint8_t Value)
{
	uint8_t tmp;
	if(MAX30102_OK != Max30102_ReadReg(REG_SPO2_CONFIG, &tmp))
		return MAX30102_ERROR;
	tmp &= ~(0x03);
	tmp |= (Value & 0x03);
	if(MAX30102_OK != Max30102_WriteReg(REG_SPO2_CONFIG, tmp))
		return MAX30102_ERROR;

	return MAX30102_OK;
}

//
//	LEDs Pulse Amplitute Configuration
//	LED Current = Value * 0.2 mA
//
MAX30102_STATUS Max30102_Led1PulseAmplitude(uint8_t Value)
{
	if(MAX30102_OK != Max30102_WriteReg(REG_LED1_PA, Value))
		return MAX30102_ERROR;
	return MAX30102_OK;
}

MAX30102_STATUS Max30102_Led2PulseAmplitude(uint8_t Value)
{
	if(MAX30102_OK != Max30102_WriteReg(REG_LED2_PA, Value))
		return MAX30102_ERROR;
	return MAX30102_OK;
}

//
//	Usage functions
//
MAX30102_STATUS Max30102_IsFingerOnSensor(void)
{
	return IsFingerOnScreen;
}

int32_t Max30102_GetHeartRate(void)
{
	return HeartRate;
}

int32_t Max30102_GetSpO2Value(void)
{
	int Sp02;
	if (Sp02Value > 0)
	{
		Sp02 = 100 - (Sp02Value/40);
		return Sp02;
	}
	else
	{
		return Sp02Value;
	}

	return Sp02Value;
}

void Max30102_Task(void)
{
	switch(StateMachine)
	{
		case MAX30102_STATE_BEGIN:
			HeartRate = 0;
			Sp02Value = 0;
			if(IsFingerOnScreen)
			{
				CollectedSamples = 0;
				BufferTail = BufferHead;
				Max30102_Led1PulseAmplitude(MAX30102_RED_LED_CURRENT_HIGH);
				Max30102_Led2PulseAmplitude(MAX30102_IR_LED_CURRENT_HIGH);
				StateMachine = MAX30102_STATE_CALIBRATE;
			}
			break;

		case MAX30102_STATE_CALIBRATE:
				if(IsFingerOnScreen)
				{
					if(CollectedSamples > (MAX30102_BUFFER_LENGTH-MAX30102_SAMPLES_PER_SECOND))
					{
						StateMachine = MAX30102_STATE_CALCULATE_HR;
					}
				}
				else
				{
					Max30102_Led1PulseAmplitude(MAX30102_RED_LED_CURRENT_LOW);
					Max30102_Led2PulseAmplitude(MAX30102_IR_LED_CURRENT_LOW);
					StateMachine = MAX30102_STATE_BEGIN;
				}
			break;

		case MAX30102_STATE_CALCULATE_HR:
			if(IsFingerOnScreen)
			{
				maxim_heart_rate_and_oxygen_saturation(IrBuffer, RedBuffer, MAX30102_BUFFER_LENGTH-MAX30102_SAMPLES_PER_SECOND, BufferTail, &Sp02Value, &Sp02IsValid, &HeartRate, &IsHrValid);
				BufferTail = (BufferTail + MAX30102_SAMPLES_PER_SECOND) % MAX30102_BUFFER_LENGTH;
				CollectedSamples = 0;
				StateMachine = MAX30102_STATE_COLLECT_NEXT_PORTION;
			}
			else
			{
				Max30102_Led1PulseAmplitude(MAX30102_RED_LED_CURRENT_LOW);
				Max30102_Led2PulseAmplitude(MAX30102_IR_LED_CURRENT_LOW);
				StateMachine = MAX30102_STATE_BEGIN;
			}
			break;

		case MAX30102_STATE_COLLECT_NEXT_PORTION:
			if(IsFingerOnScreen)
			{
				if(CollectedSamples > MAX30102_SAMPLES_PER_SECOND)
				{
					StateMachine = MAX30102_STATE_CALCULATE_HR;
				}
			}
			else
			{
				Max30102_Led1PulseAmplitude(MAX30102_RED_LED_CURRENT_LOW);
				Max30102_Led2PulseAmplitude(MAX30102_IR_LED_CURRENT_LOW);
				StateMachine = MAX30102_STATE_BEGIN;
			}
			break;
	}
}

//
//	Initialization
//
MAX30102_STATUS Max30102_Init(I2C_HandleTypeDef *i2c)
{
	uint8_t uch_dummy;
	i2c_max30102 = i2c;
	if(MAX30102_OK != Max30102_Reset()) //resets the MAX30102
		return MAX30102_ERROR;
	if(MAX30102_OK != Max30102_ReadReg(0,&uch_dummy))
		return MAX30102_ERROR;
	if(MAX30102_OK != Max30102_FifoWritePointer(0x00))
		return MAX30102_ERROR;
	if(MAX30102_OK != Max30102_FifoOverflowCounter(0x00))
		return MAX30102_ERROR;
	if(MAX30102_OK != Max30102_FifoReadPointer(0x00))
		return MAX30102_ERROR;
	if(MAX30102_OK != Max30102_FifoSampleAveraging(FIFO_SMP_AVE_1))
		return MAX30102_ERROR;
	if(MAX30102_OK != Max30102_FifoRolloverEnable(0))
		return MAX30102_ERROR;
	if(MAX30102_OK != Max30102_FifoAlmostFullValue(MAX30102_FIFO_ALMOST_FULL_SAMPLES))
		return MAX30102_ERROR;
	if(MAX30102_OK != Max30102_SetMode(MODE_SPO2_MODE))
		return MAX30102_ERROR;
	if(MAX30102_OK != Max30102_SpO2AdcRange(SPO2_ADC_RGE_4096))
		return MAX30102_ERROR;
	if(MAX30102_OK != Max30102_SpO2SampleRate(SPO2_SAMPLE_RATE))
		return MAX30102_ERROR;
	if(MAX30102_OK != Max30102_SpO2LedPulseWidth(SPO2_PULSE_WIDTH_411))
		return MAX30102_ERROR;
	if(MAX30102_OK != Max30102_Led1PulseAmplitude(MAX30102_RED_LED_CURRENT_LOW))
		return MAX30102_ERROR;
	if(MAX30102_OK != Max30102_Led2PulseAmplitude(MAX30102_IR_LED_CURRENT_LOW))
		return MAX30102_ERROR;
	if(MAX30102_OK != Max30102_SetIntAlmostFullEnabled(1))
		return MAX30102_ERROR;
	if(MAX30102_OK != Max30102_SetIntFifoDataReadyEnabled(1))
		return MAX30102_ERROR;
//	if(MAX30102_OK != Max30102_WriteReg(REG_PILOT_PA,0x7f))   // Choose value for ~ 25mA for Pilot LED
//		return MAX30102_ERROR;
	StateMachine = MAX30102_STATE_BEGIN;
	return MAX30102_OK;
}
