C-Elegans/cpe_senior_project/wsp_src/Core/Inc/ecg.h

/*
 * ecg.h
 *
 *  Created on: Mar 23, 2021
 *      Author: mnolan
 */

#ifndef INC_ECG_H_
#define INC_ECG_H_

#include <stdint.h>

#define ADC_SAMPLE_COUNT 32
typedef float sample_type_t;

extern uint8_t ecg_enabled;
// Buffer finished flag
extern volatile uint8_t buffer_finished;
extern volatile sample_type_t *buffer_ptr;

void init_ecg_acqisition(void);

void start_ecg_acqisition(void);

void stop_ecg_acquisition(void);

void ecg_tim_callback(void);

void ecg_adc_callback(uint32_t value);

void run_ecg_filter(void);

#endif /* INC_ECG_H_ */
