C-Elegans/cpe_senior_project/wsp_src/Core/Inc/morse_tx.h

/*
 * morse_tx.h
 *
 *  Created on: Mar 25, 2021
 *      Author: mnolan
 */

#ifndef INC_MORSE_TX_H_
#define INC_MORSE_TX_H_

void transmit_morse(char c);
void transmit_morse_str(const char* str);

#endif /* INC_MORSE_TX_H_ */
