C-Elegans/cpe_senior_project/(commit log)

2020-11-23 Add Drivers
2020-11-23 Add PCB files
    [io.sch, power.sch, rf.sch, senior_project_pcb.kicad_pcb, senior_project_pcb.sch]
2021-01-26 Add dispatcher and thread
2021-01-27 Add pulse oximeter circuit
    [io.sch, power.sch, pulse_oxy.sch, rf.sch, senior_project_pcb.sch]
2021-01-27 Connect up the pulse oximeter and USB
    [io.sch, power.sch, pulse_oxy.sch, senior_project_pcb.sch]
2021-01-27 Add buttons and LEDs
    [io.sch]
2021-02-02 Add temp sensor
    [io.sch, power.sch, pulse_oxy.sch, rf.sch, senior_project_pcb.kicad_pcb, senior_project_pcb.sch, temp_sensor.sch]
2021-02-16 Initial layout mostly done
    [io.sch, power.sch, pulse_oxy.sch, senior_project_pcb.kicad_pcb, senior_project_pcb.sch]
2021-02-18 Add ecg sensor
    [ecg.sch, io.sch, power.sch, pulse_oxy.sch, rf.sch, senior_project_pcb.kicad_pcb, senior_project_pcb.sch, temp_sensor.sch]
2021-02-21 Add RF/Bluetooth to PCB
    [io.sch, power.sch, pulse_oxy.sch, rf.sch, senior_project_pcb.kicad_pcb, senior_project_pcb.sch, temp_sensor.sch]
2021-02-23 PCB Update
    [ecg.sch, io.sch, power.sch, rf.sch, senior_project_pcb.kicad_pcb, senior_project_pcb.sch, temp_sensor.sch]
2021-02-25 Send PCB off for manufacture
    [ecg.sch, io.sch, power.sch, pulse_oxy.sch, senior_project_pcb.csv, senior_project_pcb.kicad_pcb, temp_sensor.sch]
2021-03-03 Add ADC interrupt (not working though)
    [main.c, rtos_test2.ioc]
2021-03-03 Add ADC end of conversion interrupt example
2021-03-06 Add project for STM32WB55 MCU
2021-03-10 Begin testing the PCB
2021-03-10 USB Working, enable and print ADC
2021-03-10 Add thermistor calculations
2021-03-16 Added correct thermopile calculations
    [main.c, temperature.c]
2021-03-17 Enable timer 2 interrupt
2021-03-18 Add in paul's changes for I2C
2021-03-25 Add FIR filter coefficients and machinery
    [filter_coeff.csv]
2021-03-25 Add code to blink the LED in morse code
2021-04-06 Doing some ECG testing, trying to print (float32_t)filter_output
2021-04-06 Begin adding tabs for ECG and Temperature
2021-04-06 add pcb gitignore
2021-04-06 Add temperature history list to temperature tab
2021-04-06 Made the buffer printing better
2021-04-10 Add interface to have das print data from USB
2021-04-10 Add method to get a temperature data point
2021-04-10 Successfully read temperature data from device and display in GUI
2021-04-10 Sort the temperature column
2021-04-11 Fix SPO2 sensor not working
    [main.c, main.h, spamm_wsp.ioc]
2021-04-13 Minor fixes after merge
    [main.c, spamm_wsp.ioc]
2021-04-14 Fix getting weird values from filtered output
    [ecg.c]
2021-04-14 Add ECG Task to handle ecg IO and filter running
2021-04-14 Add ability to measure temperature from buttons
2021-04-14 Add ability to start and stop ECG through button menu
2021-04-15 Create worker thread to read ecg data
2021-04-15 Further tweaks to sensor
2021-04-18 Add sleep and oximeter to button menu
